robocore-labs/link101-hardware/link101_carrier/link101_carrier.kicad_pcb

## KiCad design link101_carrier/link101_carrier.kicad_pcb (2026-07-08)

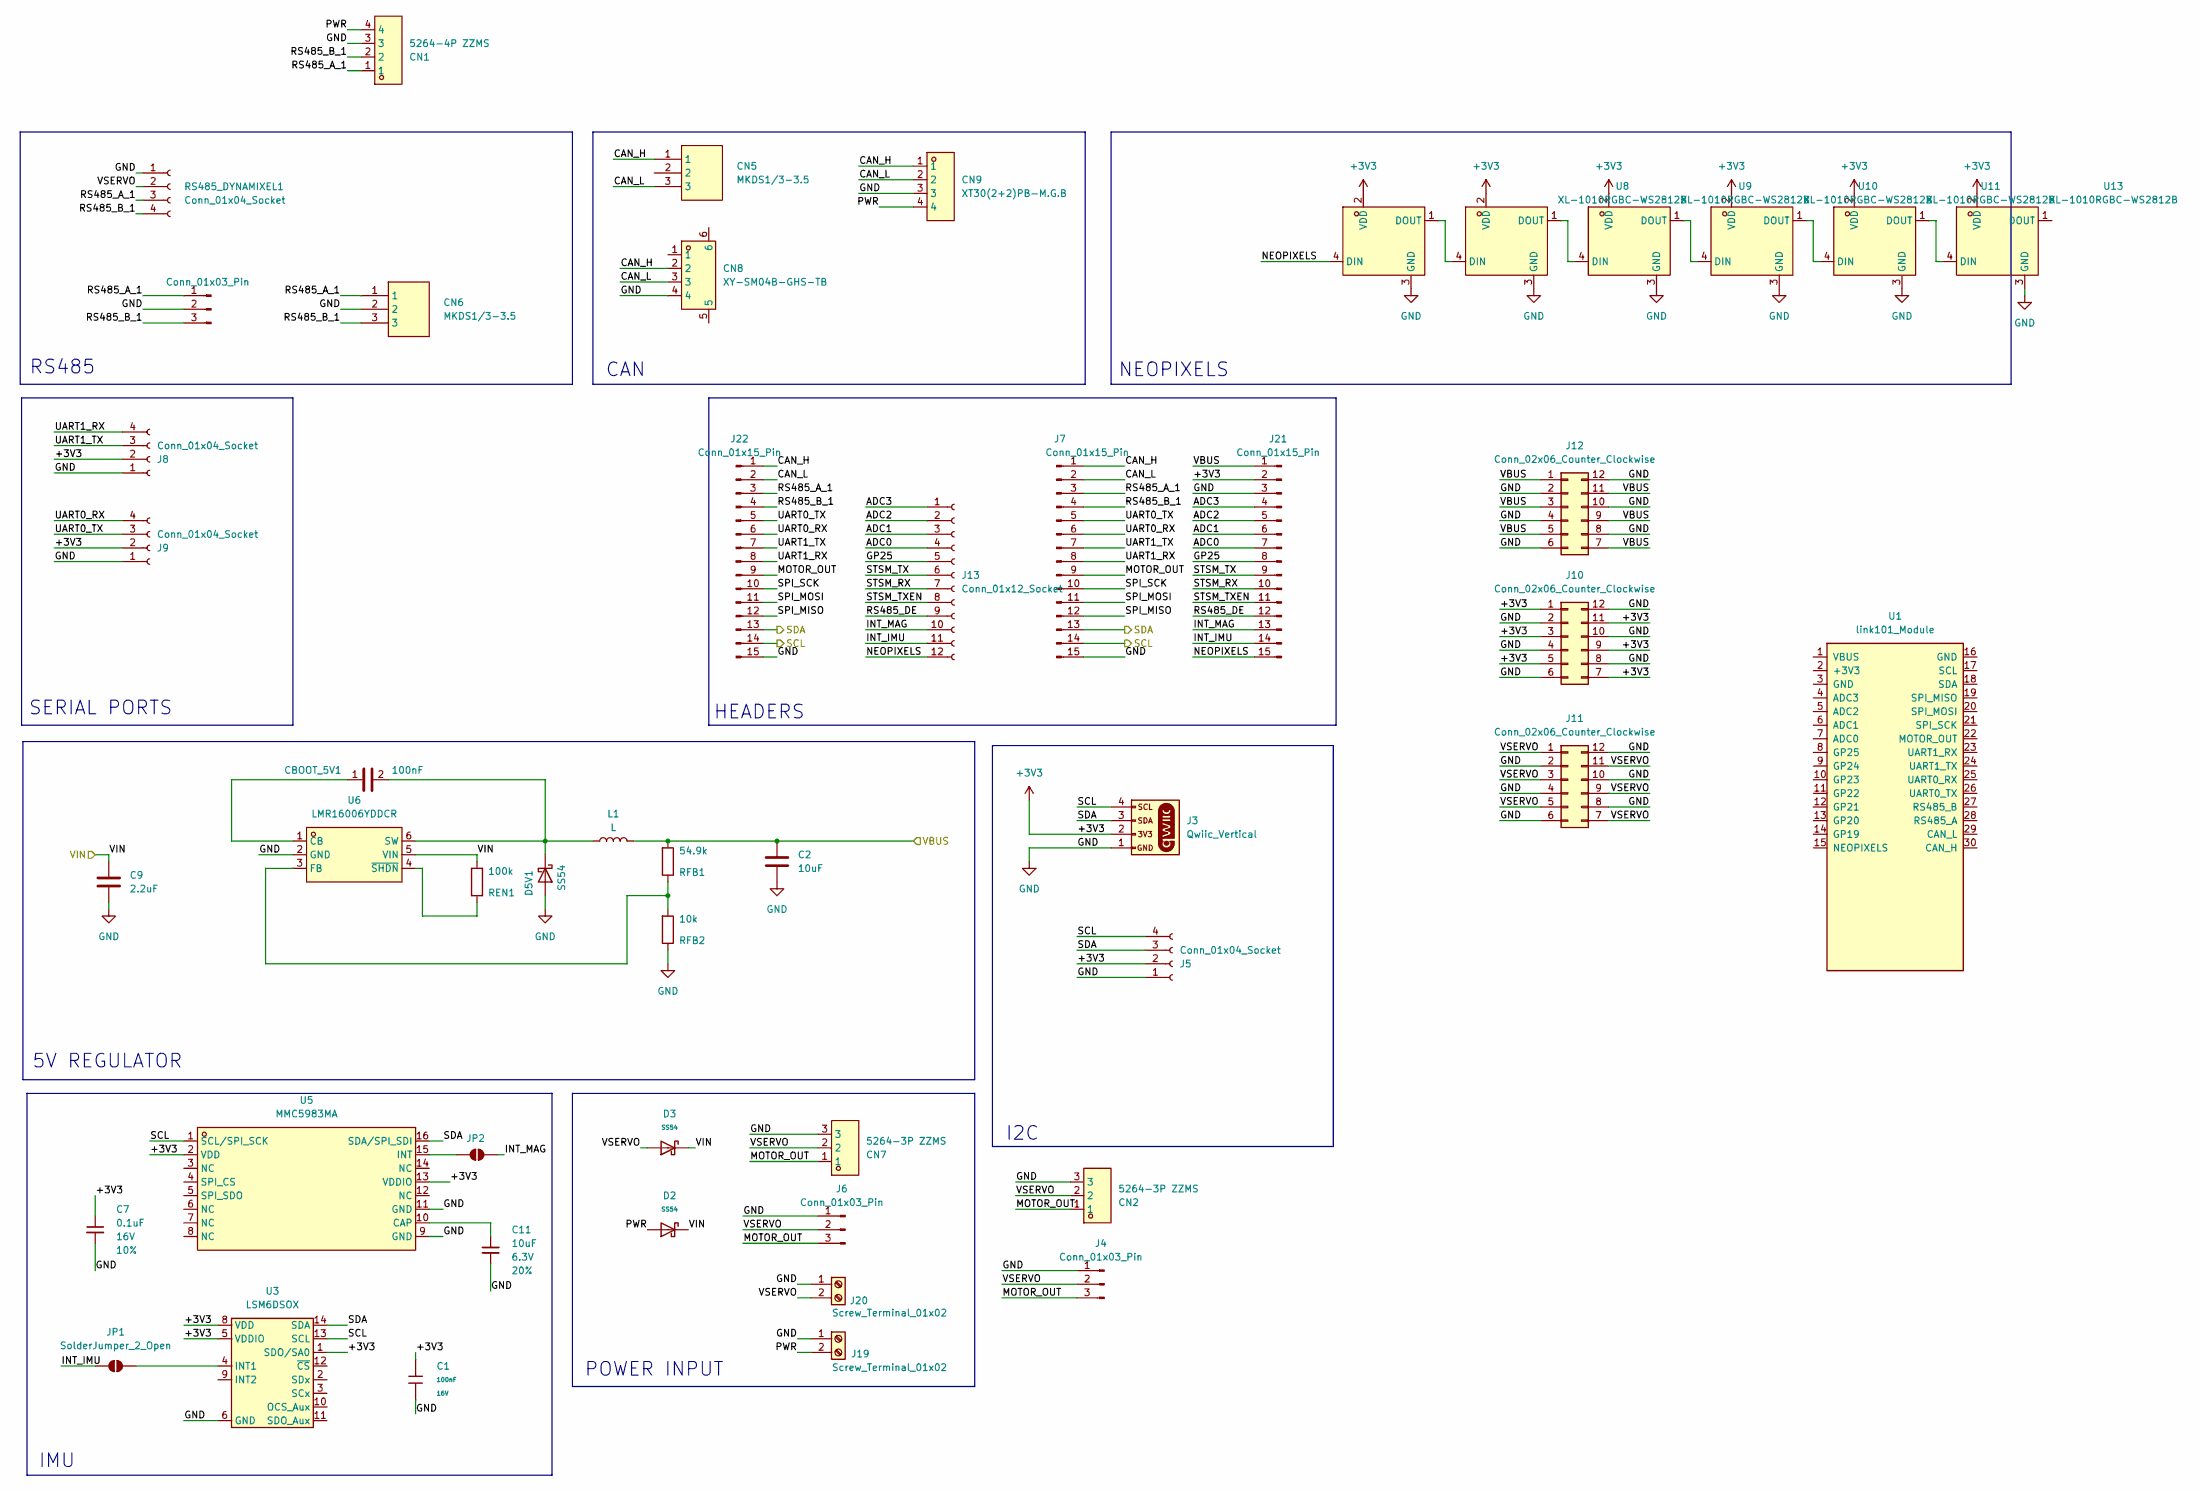
[picture p2: schematic link101_carrier.kicad_sch]

Parts:
C1: 100nF; C_0402; Voltage Rated 16V; Tolerance ±10%; Part CL05B104KO5NNNC; LCSC C1525
C2: 10uF; C_1206_3216Metric
C7: 0.1uF; C_0402_1005Metric; Voltage 16V; Tolerance 10%
C9: 2.2uF; C_1206_3216Metric
C11: 10uF; C_0402_1005Metric; Voltage 6.3V; Tolerance 20%
CBOOT_5V1: 100nF; C_0805_2012Metric
CN1: 5264-4P ZZMS; CONN-TH_4P-P2.50_5264-4P-ZZMS; LCSC Part C49023815
CN2, CN7: 5264-3P ZZMS; CONN-TH_5264-3P-ZZMS; LCSC Part C49023814
CN5, CN6: MKDS1/3-3.5; CONN-TH_3P-P3.50_1751251; LCSC Part C91152
CN8: XY-SM04B-GHS-TB; CONN-SMD_4P-P1.25_12502-04WASMT; LCSC Part C51940118
CN9: XT30(2+2)PB-M.G.B; CONN-TH_XT30PB-M; LCSC Part C19268029
D2, D3: SS54; D_2512_6332Metric; Forward Voltage (Vf@If) 550mV@5A; Reverse Voltage (Vr) 40V; Part SS54; LCSC C22452
D5V1: SS54; SMB_L4.3-W3.6-LS5.4-RD
J1: Conn_01x03_Pin; PinHeader_1x03_P2.54mm_Vertical
J3: Qwiic_Vertical; JST_1x04_P1.0mm_Vertical_SMD
J4, J6: Conn_01x03_Pin; JST_EH_B3B-EH-A_1x03_P2.50mm_Vertical
J5, J8, J9: Conn_01x04_Socket; JST_PH_B4B-PH-K_1x04_P2.00mm_Vertical
J7, J21, J22: Conn_01x15_Pin; PinSocket_1x15_P2.54mm_Vertical
J10, J11, J12: Conn_02x06_Counter_Clockwise; PinSocket_2x06_P2.54mm_Vertical
J13: Conn_01x12_Socket; PinSocket_1x12_P2.54mm_Vertical
J19, J20: Screw_Terminal_01x02; TerminalBlock_MetzConnect_Type094_RT03502HBLU_1x02_P5.00mm_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
JP1, JP2: SolderJumper_2_Open; SolderJumper-2_P1.3mm_Open_RoundedPad1.0x1.5mm
L1: L; L_Cenker_CKCS5040
REN1: 100k; R_0603_1608Metric
RFB1: 54.9k; R_0603_1608Metric
RFB2: 10k; R_0603_1608Metric
RS485_DYNAMIXEL1: Conn_01x04_Socket; JST_EH_B4B-EH-A_1x04_P2.50mm_Vertical
U1: link101_Module
U3: LSM6DSOX; ST_LGA-14L_2.5x3.0mm_P0.5mm_4x3
U5: MMC5983MA; LGA-16_L3.0-W3.0-P0.50-BL_SQ; LCSC Part C404329
U6: LMR16006YDDCR; SOT-23-6_L2.9-W1.6-P0.95-LS2.8-BL; MPN LMR16006YDDCR; LCSC Part C290195
U7, U8, U9, U10, U11, U13: XL-1010RGBC-WS2812B; LED-SMD_4P-L1.0-W1.0-TL_XL-1010RGBC-WS2812B; LCSC Part C5349953

Connections:
+3V3: C1.1, C7.1, J3.2, J5.2, J8.2, J9.2, J10.1, J10.3, J10.5, J10.7, J10.9, J10.11, J21.2, U3.1 (SDO/SA0), U3.5 (VDDIO), U3.8 (VDD), U5.2 (VDD), U5.13 (VDDIO), U7.2 (VDD), U8.2 (VDD), U9.2 (VDD), U10.2 (VDD), U11.2 (VDD), U13.2 (VDD)
/ADC0: J13.4, J21.7
/ADC1: J13.3, J21.6
/ADC2: J13.2, J21.5
/ADC3: J13.1, J21.4
/CAN_H: CN5.1, CN8.2, CN9.1, J7.1, J22.1
/CAN_L: CN5.3, CN8.3, CN9.2, J7.2, J22.2
/GP25: J13.5, J21.8
/INT_IMU: J13.11, J21.14, JP1.1 (A)
/INT_MAG: J13.10, J21.13, JP2.2 (B)
/MOTOR_OUT: CN2.1, CN7.1, J4.3, J6.3, J7.9, J22.9
/NEOPIXELS: J13.12, J21.15, U7.4 (DIN)
/PWR: CN1.4, CN9.4, D2.2, J19.2
/RS485_A_1: CN1.1, CN6.1, J1.1, J7.3, J22.3, RS485_DYNAMIXEL1.3
/RS485_B_1: CN1.2, CN6.3, J1.3, J7.4, J22.4, RS485_DYNAMIXEL1.4
/RS485_DE: J13.9, J21.12
/SCL: J3.4, J5.4, J7.14, J22.14, U3.13 (SCL), U5.1 (SCL/SPI_SCK)
/SDA: J3.3, J5.3, J7.13, J22.13, U3.14 (SDA), U5.16 (SDA/SPI_SDI)
/SPI_MISO: J7.12, J22.12
/SPI_MOSI: J7.11, J22.11
/SPI_SCK: J7.10, J22.10
/STSM_RX: J13.7, J21.10
/STSM_TX: J13.6, J21.9
/STSM_TXEN: J13.8, J21.11
/UART0_RX: J7.6, J9.4, J22.6
/UART0_TX: J7.5, J9.3, J22.5
/UART1_RX: J7.8, J8.4, J22.8
/UART1_TX: J7.7, J8.3, J22.7
/VBUS: C2.1, J12.1, J12.3, J12.5, J12.7, J12.9, J12.11, J21.1, L1.2, RFB1.2
/VIN: C9.1, D2.1, D3.1, REN1.2, U6.5 (VIN)
/VSERVO: CN2.2, CN7.2, D3.2, J4.2, J6.2, J11.1, J11.3, J11.5, J11.7, J11.9, J11.11, J20.2, RS485_DYNAMIXEL1.2
GND: C1.2, C2.2, C7.2, C9.2, C11.2, CN1.3, CN2.3, CN6.2, CN7.3, CN8.4, CN9.3, D5V1.2 (A), J1.2, J3.1, J4.1, J5.1, J6.1, J7.15, J8.1, J9.1, J10.2, J10.4, J10.6, J10.8, J10.10, J10.12, J11.2, J11.4, J11.6, J11.8, J11.10, J11.12, J12.2, J12.4, J12.6, J12.8, J12.10, J12.12, J19.1, J20.1, J21.3, J22.15, RFB2.1, RS485_DYNAMIXEL1.1, U3.6 (GND), U3.7 (GND), U5.9 (GND), U5.11 (GND), U6.2 (GND), U7.3 (GND), U8.3 (GND), U9.3 (GND), U10.3 (GND), U11.3 (GND), U13.3 (GND)
unnamed: CBOOT_5V1.2, D5V1.1 (K), L1.1, U6.6 (SW)
unnamed: JP1.2 (B), U3.4 (INT1)
unnamed: JP2.1 (A), U5.15 (INT)
unnamed: C11.1, U5.10 (CAP)
unnamed: CBOOT_5V1.1, U6.1 (CB)
unnamed: RFB1.1, RFB2.2, U6.3 (FB)
unnamed: REN1.1, U6.4 (~SHDN)
unnamed: U7.1 (DOUT), U8.4 (DIN)
unnamed: U8.1 (DOUT), U9.4 (DIN)
unnamed: U9.1 (DOUT), U10.4 (DIN)
unnamed: U10.1 (DOUT), U11.4 (DIN)
unnamed: U11.1 (DOUT), U13.4 (DIN)

Notes on the sheet:
HEADERS
I2C
IMU
5V REGULATOR
RS485
SERIAL PORTS
POWER INPUT
CAN
NEOPIXELS

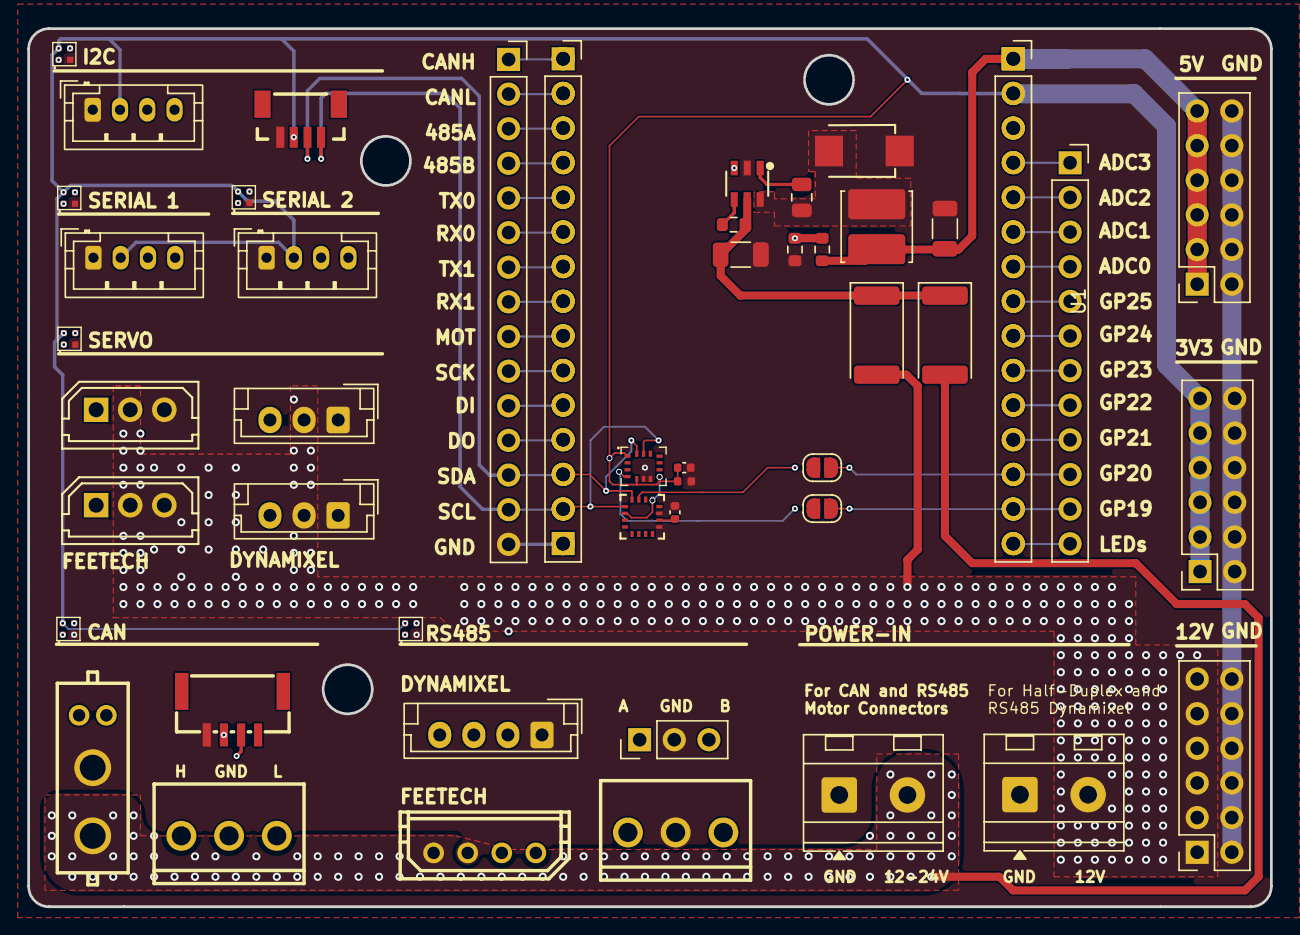
[picture p3: board link101_carrier.kicad_pcb from above]

Board: 4 copper layers, 91.1 x 64.4 mm, 49 parts (0 on the bottom side), 44 nets.
