robocore-labs/link101-hardware/link101/link101.kicad_pcb

## KiCad design link101/link101.kicad_pcb (2026-07-03)

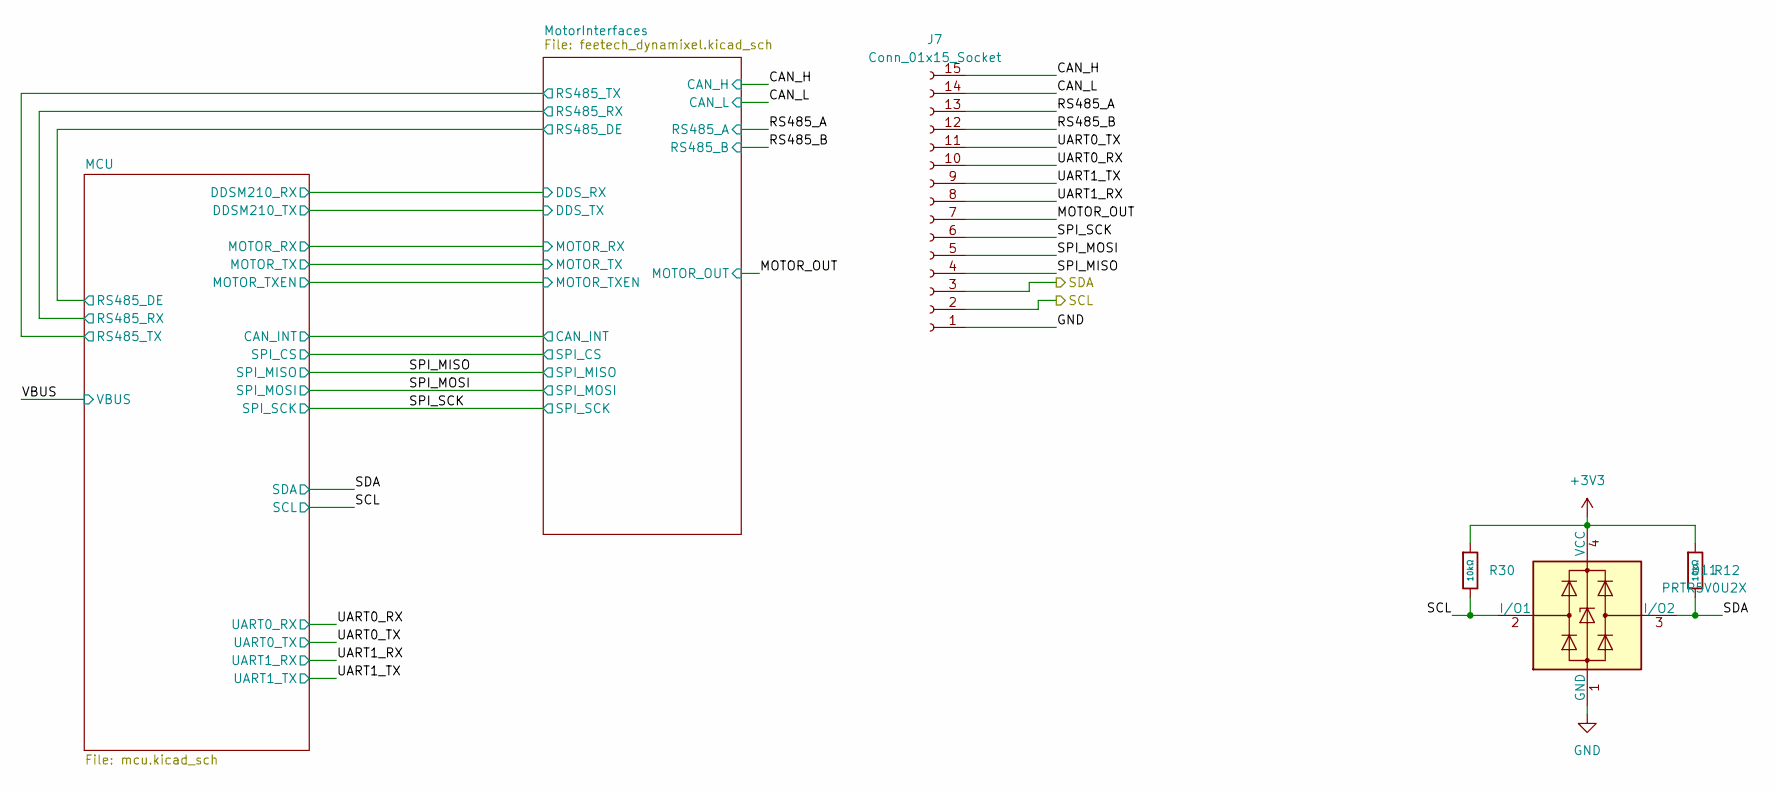
[picture p4: schematic link101.kicad_sch]

Parts:
D11: PRTR5V0U2X; SOT-143
J7: Conn_01x15_Socket; PinHeader_1x15_P2.54mm_Vertical
R12, R30: 10kΩ; R_0402; Overload Voltage (Max) 50V; Tolerance ±1%; Part 0402WGF1002TCE; LCSC C25744

Connections:
+3V3: D11.4 (VCC), R12.1, R30.1; also elsewhere on the board
/CAN_H: J7.15; also elsewhere on the board
/CAN_L: J7.14; also elsewhere on the board
/MOTOR_OUT: J7.7; also elsewhere on the board
/RS485_A: J7.13; also elsewhere on the board
/RS485_B: J7.12; also elsewhere on the board
/SCL: D11.2 (I/O1), J7.2, R30.2; also elsewhere on the board
/SDA: D11.3 (I/O2), J7.3, R12.2; also elsewhere on the board
/SPI_MISO: J7.4; also elsewhere on the board
/SPI_MOSI: J7.5; also elsewhere on the board
/SPI_SCK: J7.6; also elsewhere on the board
/UART0_RX: J7.10; also elsewhere on the board
/UART0_TX: J7.11; also elsewhere on the board
/UART1_RX: J7.8; also elsewhere on the board
/UART1_TX: J7.9; also elsewhere on the board
GND: D11.1 (GND), J7.1; also elsewhere on the board

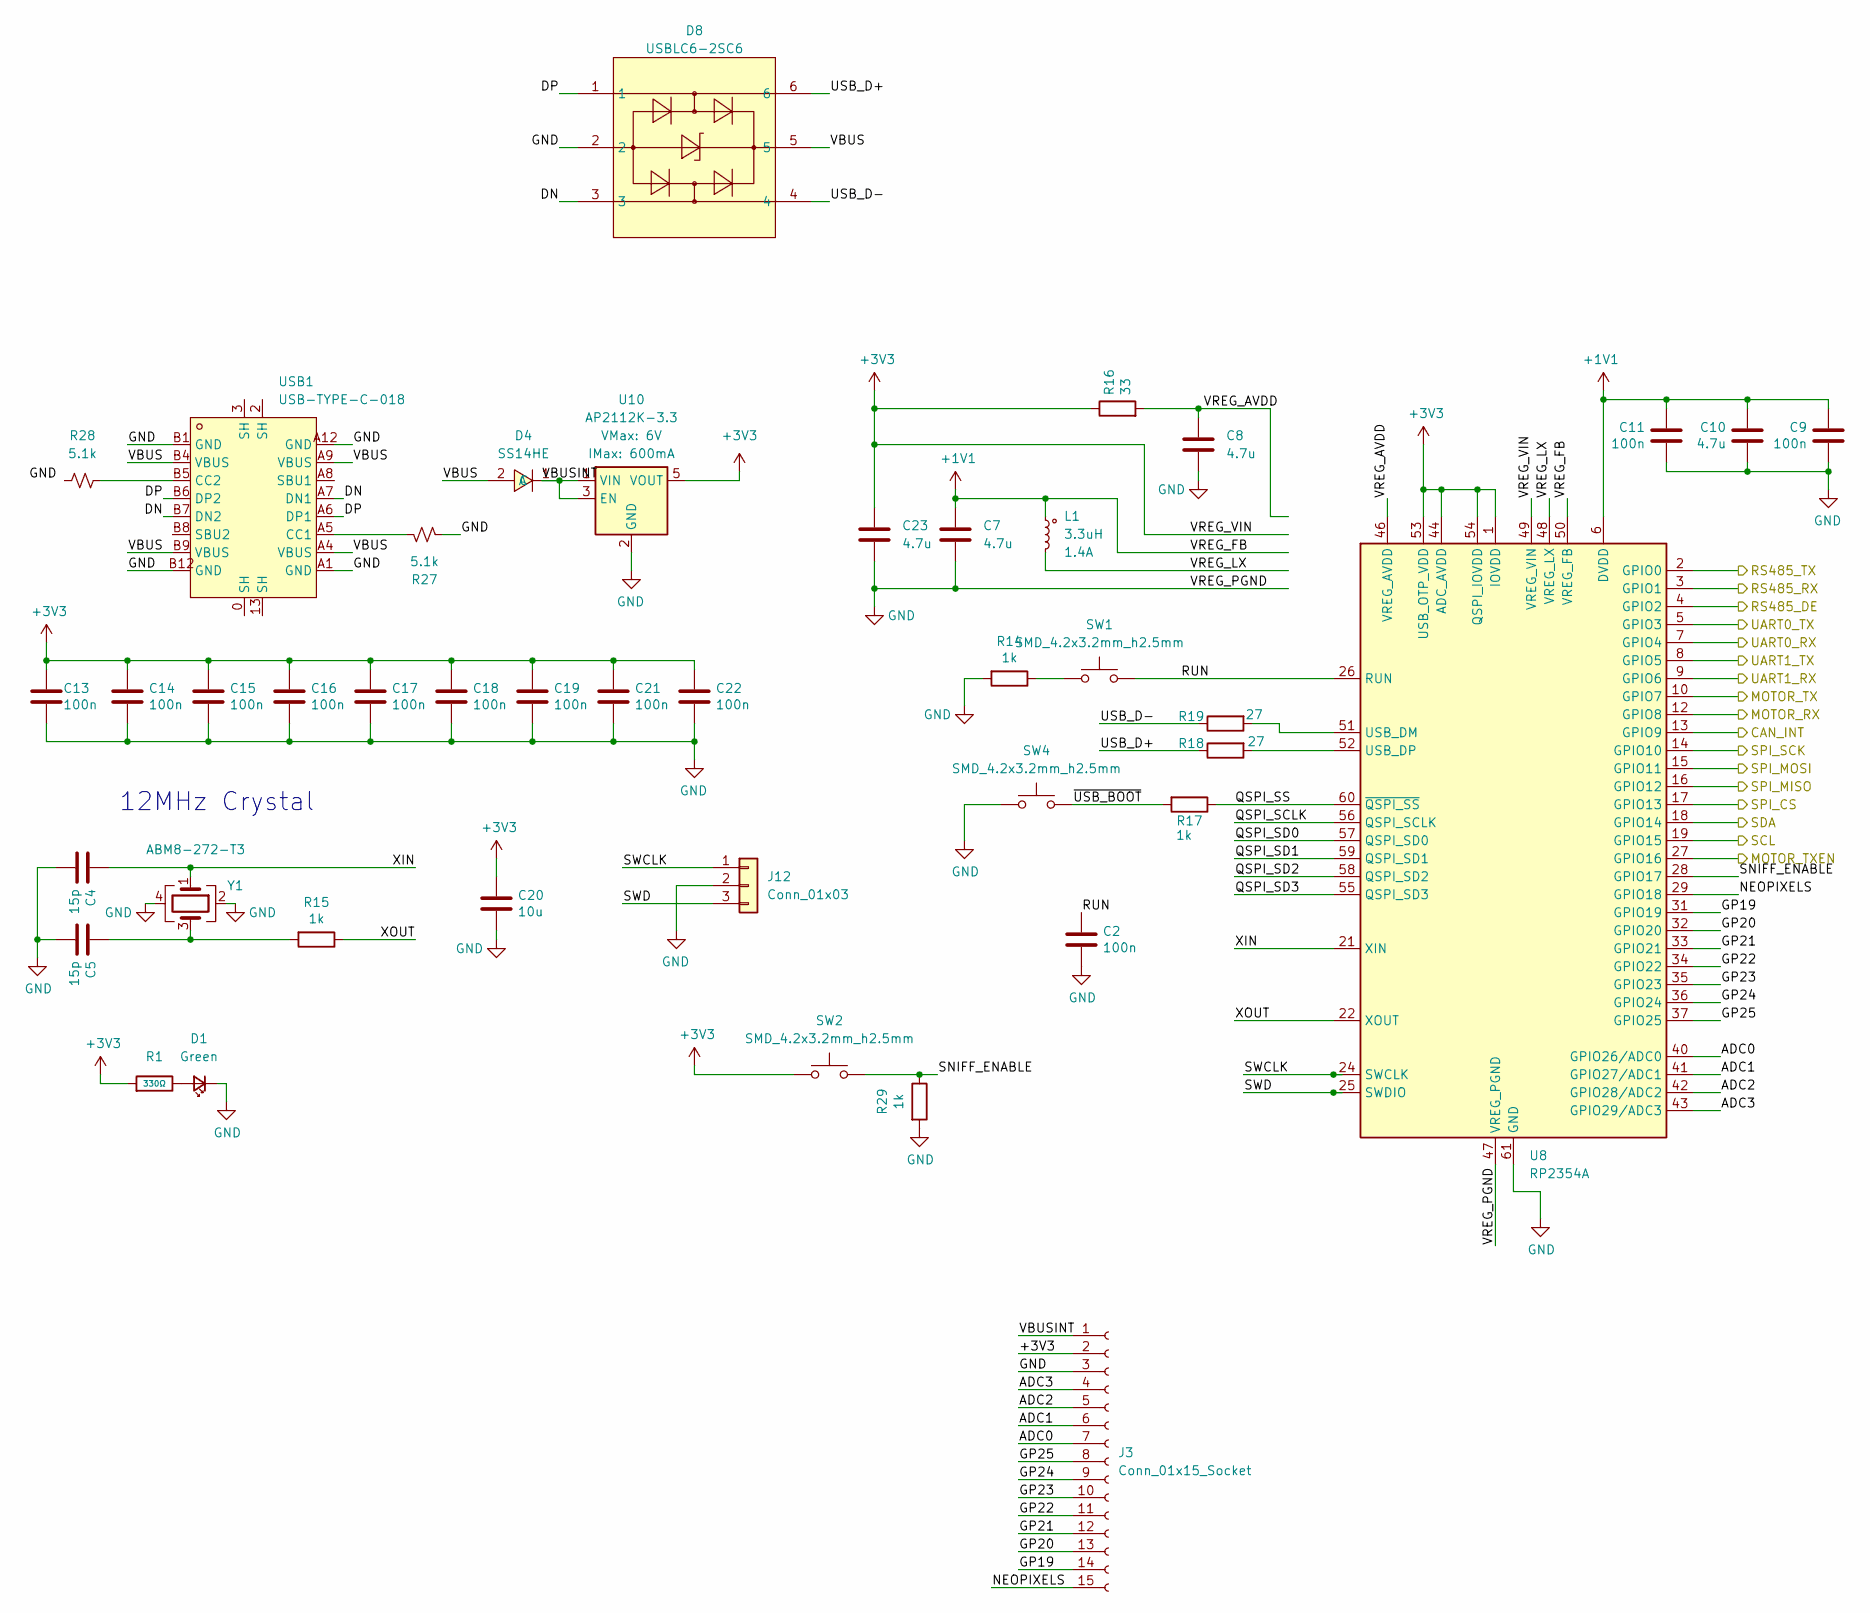
[picture p5: schematic mcu.kicad_sch]

Parts:
C2, C9, C11, C13, C14, C15, C16, C17, C18, C19, C21, C22: 100n; C_0402_1005Metric
C4, C5: 15p; C_0402_1005Metric
C7, C8, C10, C23: 4.7u; C_0402_1005Metric
C20: 10u; C_0805_2012Metric
D1: Green; LED_0603_1608Metric_Green
D4: SS14HE; SOD-323HE_L1.9-W1.3-LS2.5-RD; LCSC Part C28646397
D8: USBLC6-2SC6; SOT-23-6_L2.9-W1.6-P0.95-LS2.8-BL; LCSC Part C7519
J3: Conn_01x15_Socket; PinHeader_1x15_P2.54mm_Vertical
J12: Conn_01x03; 1x03_P2.54mm_Locking
L1: 3.3uH; 0806_Polarized
R1: 330Ω; R_0402; Overload Voltage (Max) 50V; Tolerance ±1%; Part 0402WGF3300TCE; LCSC C25104
R14, R15, R17, R29: 1k; R_0402_1005Metric
R16: 33; R_0402_1005Metric
R18, R19: 27; R_0402_1005Metric
R27, R28: 5.1k; R_0402_1005Metric
SW1, SW2, SW4: SMD_4.2x3.2mm_h2.5mm; Push_SMD_4.2x3.2mm
U8: RP2354A; QFN-60-1EP_7x7mm_P0.4mm_EP3.4x3.4mm
U10: AP2112K-3.3; SOT23-5
USB1: USB-TYPE-C-018; USB-C_SMD-TYPE-C-31-M-12; LCSC Part C2927038
Y1: ABM8-272-T3; Crystal_SMD_3225-4Pin_3.2x2.5mm

Connections:
+1V1: C7.1, C9.1, C10.1, C11.1, L1.1, U8.6 (DVDD), U8.23 (DVDD), U8.39 (DVDD), U8.50 (VREG_FB)
+3V3: C13.1, C14.1, C15.1, C16.1, C17.1, C18.1, C19.1, C20.1, C21.1, C22.1, C23.1, J3.2, R1.1, R16.1, SW2.1, U8.1 (IOVDD), U8.11 (IOVDD), U8.20 (IOVDD), U8.30 (IOVDD), U8.38 (IOVDD), U8.44 (ADC_AVDD), U8.45 (IOVDD), U8.49 (VREG_VIN), U8.53 (USB_OTP_VDD), U8.54 (QSPI_IOVDD), U10.5 (VOUT); also elsewhere on the board
/MCU/ADC0: J3.7, U8.40 (GPIO26/ADC0)
/MCU/ADC1: J3.6, U8.41 (GPIO27/ADC1)
/MCU/ADC2: J3.5, U8.42 (GPIO28/ADC2)
/MCU/ADC3: J3.4, U8.43 (GPIO29/ADC3)
/MCU/CAN_INT: U8.13 (GPIO9); also elsewhere on the board
/MCU/DN: D8.3, USB1.A7 (DN1), USB1.B7 (DN2)
/MCU/DP: D8.1, USB1.A6 (DP1), USB1.B6 (DP2)
/MCU/GP19: J3.14, U8.31 (GPIO19)
/MCU/GP20: J3.13, U8.32 (GPIO20)
/MCU/GP21: J3.12, U8.33 (GPIO21)
/MCU/GP22: J3.11, U8.34 (GPIO22)
/MCU/GP23: J3.10, U8.35 (GPIO23)
/MCU/GP24: J3.9, U8.36 (GPIO24)
/MCU/GP25: J3.8, U8.37 (GPIO25)
/MCU/NEOPIXELS: J3.15, U8.29 (GPIO18)
/MCU/QSPI_SCLK: U8.56 (QSPI_SCLK)
/MCU/QSPI_SD0: U8.57 (QSPI_SD0)
/MCU/QSPI_SD1: U8.59 (QSPI_SD1)
/MCU/QSPI_SD2: U8.58 (QSPI_SD2)
/MCU/QSPI_SD3: U8.55 (QSPI_SD3)
/MCU/QSPI_SS: R17.1, U8.60 (~QSPI_SS)
/MCU/RS485_DE: U8.4 (GPIO2); also elsewhere on the board
/MCU/RS485_RX: U8.3 (GPIO1); also elsewhere on the board
/MCU/RS485_TX: U8.2 (GPIO0); also elsewhere on the board
/MCU/RUN: C2.1, SW1.2, U8.26 (RUN)
/MCU/SNIFF_ENABLE: R29.1, SW2.2, U8.28 (GPIO17)
/MCU/SPI_CS: U8.17 (GPIO13); also elsewhere on the board
/MCU/SWCLK: J12.1, U8.24 (SWCLK)
/MCU/SWD: J12.3, U8.25 (SWDIO)
/MCU/USB_D+: D8.6, R18.1
/MCU/USB_D-: D8.4, R19.1
/MCU/VBUS: D4.2 (A), D8.5, USB1.A4 (VBUS), USB1.A9 (VBUS), USB1.B4 (VBUS), USB1.B9 (VBUS)
/MCU/VBUSINT: D4.1 (C), J3.1, U10.1 (VIN), U10.3 (EN)
/MCU/VREG_AVDD: C8.1, R16.2, U8.46 (VREG_AVDD)
/MCU/VREG_LX: L1.2, U8.48 (VREG_LX)
/MCU/XIN: C4.1, U8.21 (XIN), Y1.1
/MCU/XOUT: R15.1, U8.22 (XOUT)
/MCU/~USB_BOOT: R17.2, SW4.2
/MotorInterfaces/STSM_RX: U8.12 (GPIO8); also elsewhere on the board
/MotorInterfaces/STSM_TX: U8.10 (GPIO7); also elsewhere on the board
/MotorInterfaces/STSM_TXEN: U8.27 (GPIO16); also elsewhere on the board
/SCL: U8.19 (GPIO15); also elsewhere on the board
/SDA: U8.18 (GPIO14); also elsewhere on the board
/SPI_MISO: U8.16 (GPIO12); also elsewhere on the board
/SPI_MOSI: U8.15 (GPIO11); also elsewhere on the board
/SPI_SCK: U8.14 (GPIO10); also elsewhere on the board
/UART0_RX: U8.7 (GPIO4); also elsewhere on the board
/UART0_TX: U8.5 (GPIO3); also elsewhere on the board
/UART1_RX: U8.9 (GPIO6); also elsewhere on the board
/UART1_TX: U8.8 (GPIO5); also elsewhere on the board
GND: C2.2, C4.2, C5.2, C7.2, C8.2, C9.2, C10.2, C11.2, C13.2, C14.2, C15.2, C16.2, C17.2, C18.2, C19.2, C20.2, C21.2, C22.2, C23.2, D1.1 (K), D8.2, J3.3, J12.2, R14.2, R27.2, R29.2, SW4.1, U8.47 (VREG_PGND), U8.61 (GND), U10.2 (GND), USB1.A1 (GND), USB1.A12 (GND), USB1.B1 (GND), USB1.B12 (GND), Y1.2, Y1.4; also elsewhere on the board
unnamed: C5.1, R15.2, Y1.3
unnamed: D1.2 (A), R1.2
unnamed: R14.1, SW1.1
unnamed: R19.2, U8.51 (USB_DM)
unnamed: R18.2, U8.52 (USB_DP)
unnamed: R27.1, USB1.A5 (CC1)
unnamed: R28.2, USB1.B5 (CC2)

Notes on the sheet:
12MHz Crystal

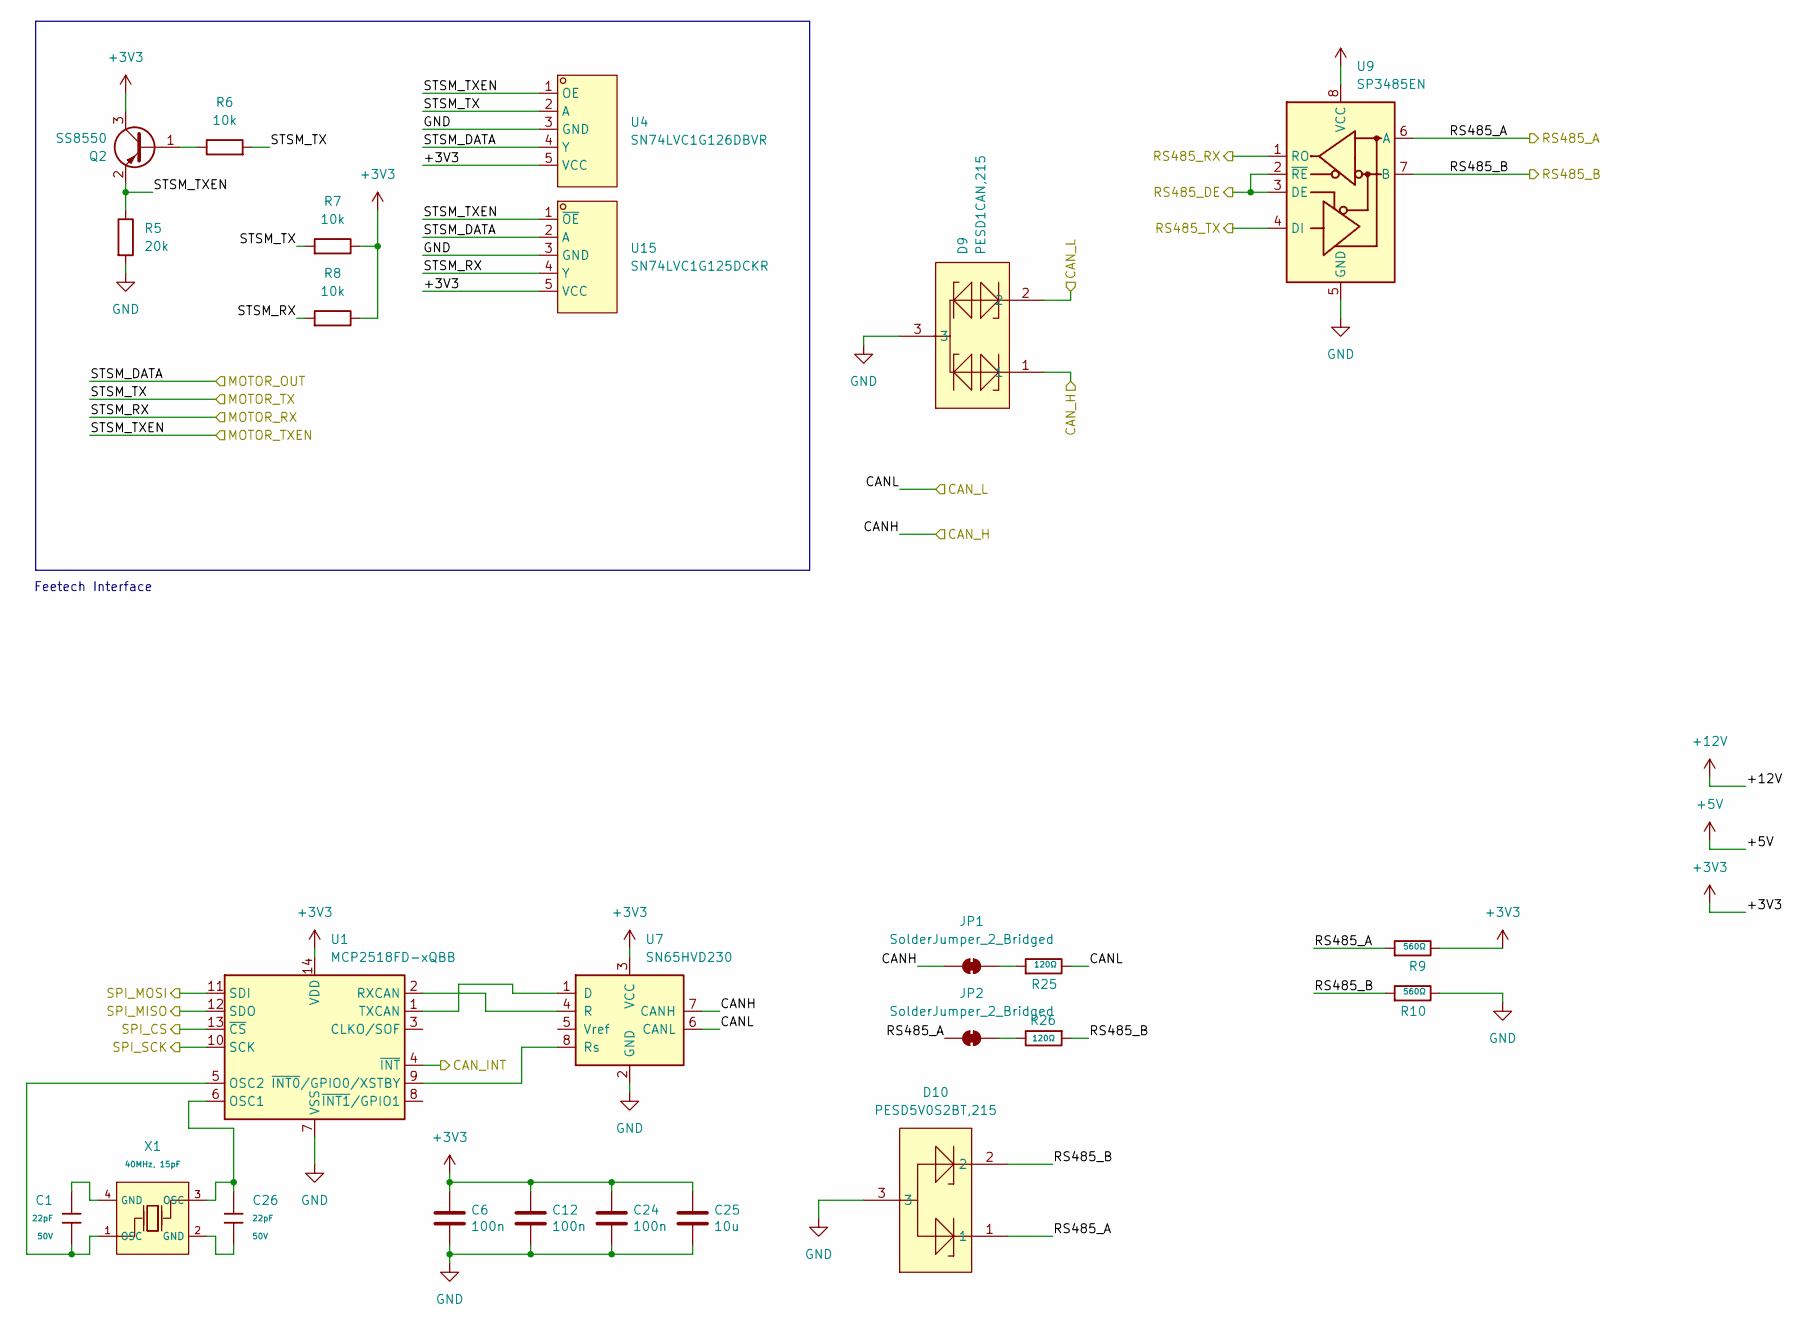
[picture p6: schematic feetech_dynamixel.kicad_sch]

Parts:
C1, C26: 22pF; C_0402; Voltage Rated 50V; Tolerance ±5%; Part 0402CG270J500NT; LCSC C1557
C6, C12, C24: 100n; C_0402_1005Metric
C25: 10u; C_0805_2012Metric
D9: PESD1CAN,215; SOT-23_L2.9-W1.3-P1.90-LS2.4-BR; LCSC Part C15771
D10: PESD5V0S2BT,215; SOT-23_L2.9-W1.3-P1.90-LS2.4-BR; LCSC Part C49338
JP1, JP2: SolderJumper_2_Bridged; SolderJumper-2_P1.3mm_Bridged_Pad1.0x1.5mm
Q2: SS8550; SOT-23
R5: 20k; R_0402_1005Metric
R6, R7, R8: 10k; R_0402_1005Metric
R9, R10: 560Ω; R_0402; Overload Voltage (Max) 50V; Tolerance ±1%; Part 0402WGF1200TCE; LCSC C25079
R25, R26: 120Ω; R_0402; Overload Voltage (Max) 50V; Tolerance ±1%; Part 0402WGF1200TCE; LCSC C25079
U1: MCP2518FD-xQBB; DFN-14-1EP_3x4.5mm_P0.65mm_EP1.65x4.25mm
U4: SN74LVC1G126DBVR; SOT-23-5_L3.0-W1.7-P0.95-LS2.8-BR; LCSC Part C7834
U7: SN65HVD230; SOIC-8_3.9x4.9mm_P1.27mm
U9: SP3485EN; SOIC-8_3.9x4.9mm_P1.27mm
U15: SN74LVC1G125DCKR; SOT-353_L2.2-W1.4-P0.65-LS2.4-BR; LCSC Part C7833
X1: 40MHz, 15pF; OSC-SMD_4P-L3.2-W2.5-BL_SIT8008BI; PartID X322540MPB4SI; LCSC C9010

Connections:
+3V3: C6.1, C12.1, C24.1, C25.1, Q2.3 (C), R7.1, R8.1, R9.2, U1.14 (VDD), U4.5 (VCC), U7.3 (VCC), U9.8 (VCC), U15.5 (VCC); also elsewhere on the board
/CAN_H: D9.1, JP1.1 (A), U7.7 (CANH); also elsewhere on the board
/CAN_L: D9.2, R25.2, U7.6 (CANL); also elsewhere on the board
/MCU/CAN_INT: U1.4 (~INT); also elsewhere on the board
/MCU/RS485_DE: U9.2 (~RE), U9.3 (DE); also elsewhere on the board
/MCU/RS485_RX: U9.1 (RO); also elsewhere on the board
/MCU/RS485_TX: U9.4 (DI); also elsewhere on the board
/MCU/SPI_CS: U1.13 (~CS); also elsewhere on the board
/MOTOR_OUT: U4.4 (Y), U15.2 (A); also elsewhere on the board
/MotorInterfaces/STSM_RX: R8.2, U15.4 (Y); also elsewhere on the board
/MotorInterfaces/STSM_TX: R6.2, R7.2, U4.2 (A); also elsewhere on the board
/MotorInterfaces/STSM_TXEN: Q2.2 (E), R5.1, U4.1 (OE), U15.1 (~OE); also elsewhere on the board
/RS485_A: D10.1, JP2.1 (A), R9.1, U9.6 (A); also elsewhere on the board
/RS485_B: D10.2, R10.1, R26.1, U9.7 (B); also elsewhere on the board
/SPI_MISO: U1.12 (SDO); also elsewhere on the board
/SPI_MOSI: U1.11 (SDI); also elsewhere on the board
/SPI_SCK: U1.10 (SCK); also elsewhere on the board
GND: C6.2, C12.2, C24.2, C25.2, D9.3, D10.3, R5.2, R10.2, U1.7 (VSS), U1.15 (VSS), U4.3 (GND), U7.2 (GND), U9.5 (GND), U15.3 (GND); also elsewhere on the board
unnamed: C1.1, X1.4 (GND)
unnamed: C26.2, X1.2 (GND)
unnamed: JP1.2 (B), R25.1
unnamed: JP2.2 (B), R26.2
unnamed: Q2.1 (B), R6.1
unnamed: C26.1, U1.6 (OSC1), X1.3 (OSC)
unnamed: C1.2, U1.5 (OSC2), X1.1 (OSC)
unnamed: U1.2 (RXCAN), U7.4 (R)
unnamed: U1.1 (TXCAN), U7.1 (D)
unnamed: U1.9 (~INT0/GPIO0/XSTBY), U7.8 (Rs)

Notes on the sheet:
Feetech Interface

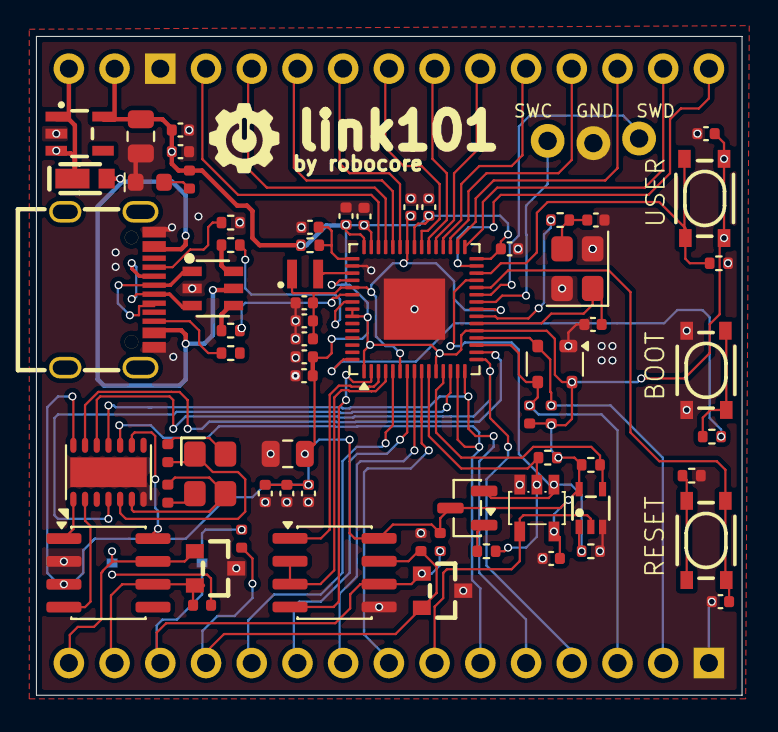
[picture p7: board link101.kicad_pcb from above]

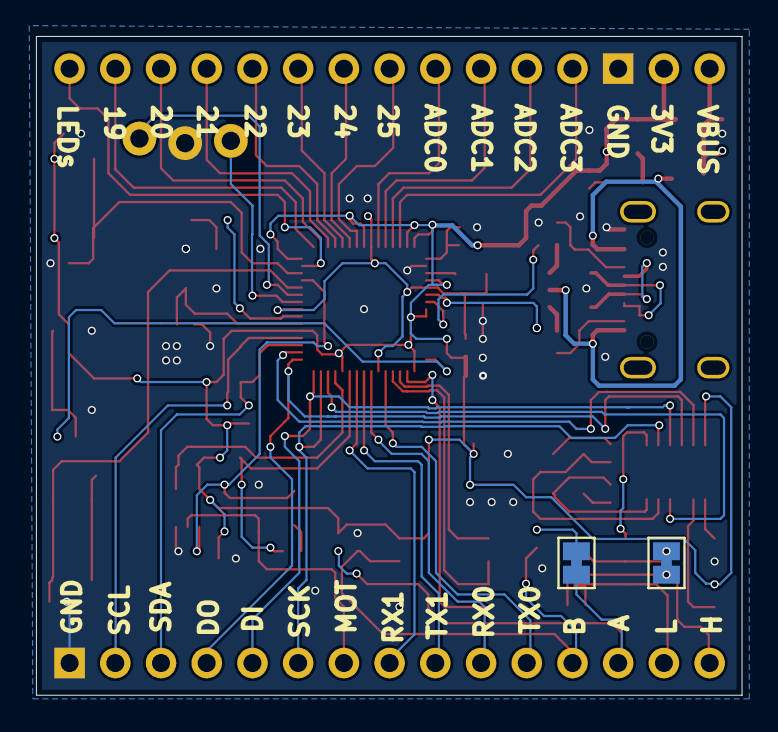
[picture p8: board link101.kicad_pcb from below]

Board: 2 copper layers, 39.2 x 36.6 mm, 71 parts (4 on the bottom side), 70 nets.
