robocore-labs/link101-hardware/(commit log)

2026-07-03 added readme
    [feetech_dynamixel.kicad_sch, link101.kicad_pcb, link101.kicad_sch, link101_carrier.kicad_pcb, link101_carrier.kicad_sch, mcu.kicad_sch]
2026-07-08 added pcb files
    [link101_carrier.kicad_pcb, link101_carrier.kicad_sch]
